Nicklaus228/iSerre/Image/ScreenShot_20170424103108.png

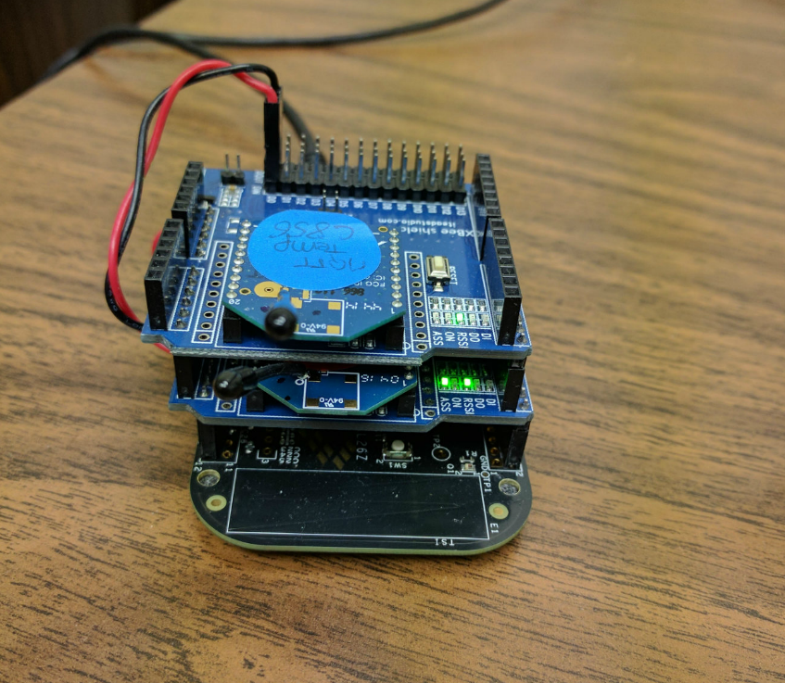
Image/ScreenShot_20170424103108.png
