Nicklaus228/iSerre/Image/passerelle.png

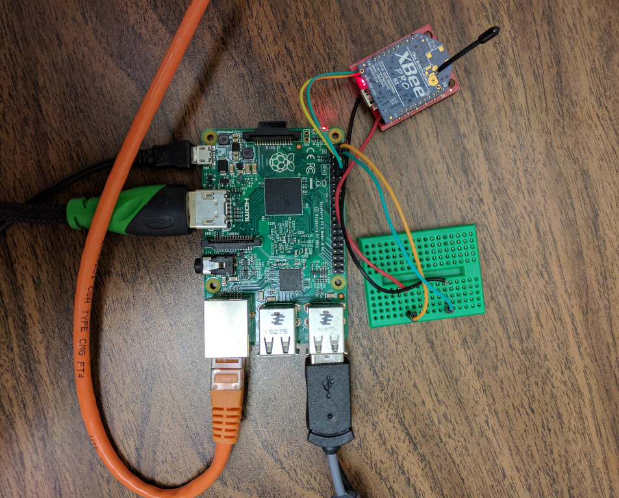
Image/passerelle.png
