Nicklaus228/iSerre/README.md

# iSerre
Ce projet vise à mettre au point une serre électronique automatisée dont les paramètres environnementaux sont configurables par exemple : la température, l’humidité etc. 

Présentation sur prezi : https://prezi.com/t4i6kgrugdgb/
