Nicklaus228/iSerre/Logiciels/Liste des logiciels utilisés.txt

lien google drive vers les logiciels utiliés dans ce projet 

https://drive.google.com/drive/folders/0B7enBIbdItrnTFJWbEdfZEJibTg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
