Nicklaus228/iSerre/Image/Algo.png

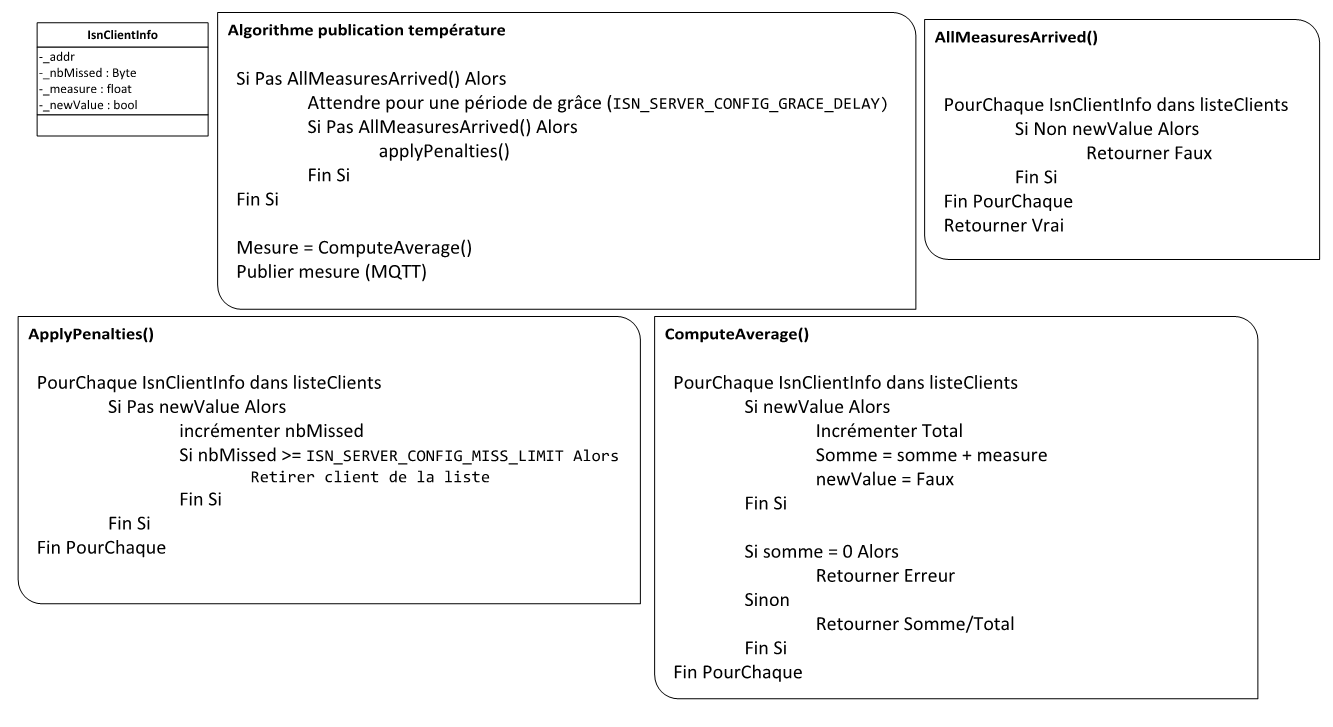
Image/Algo.png
