Nicklaus228/iSerre/Image/architecture.png

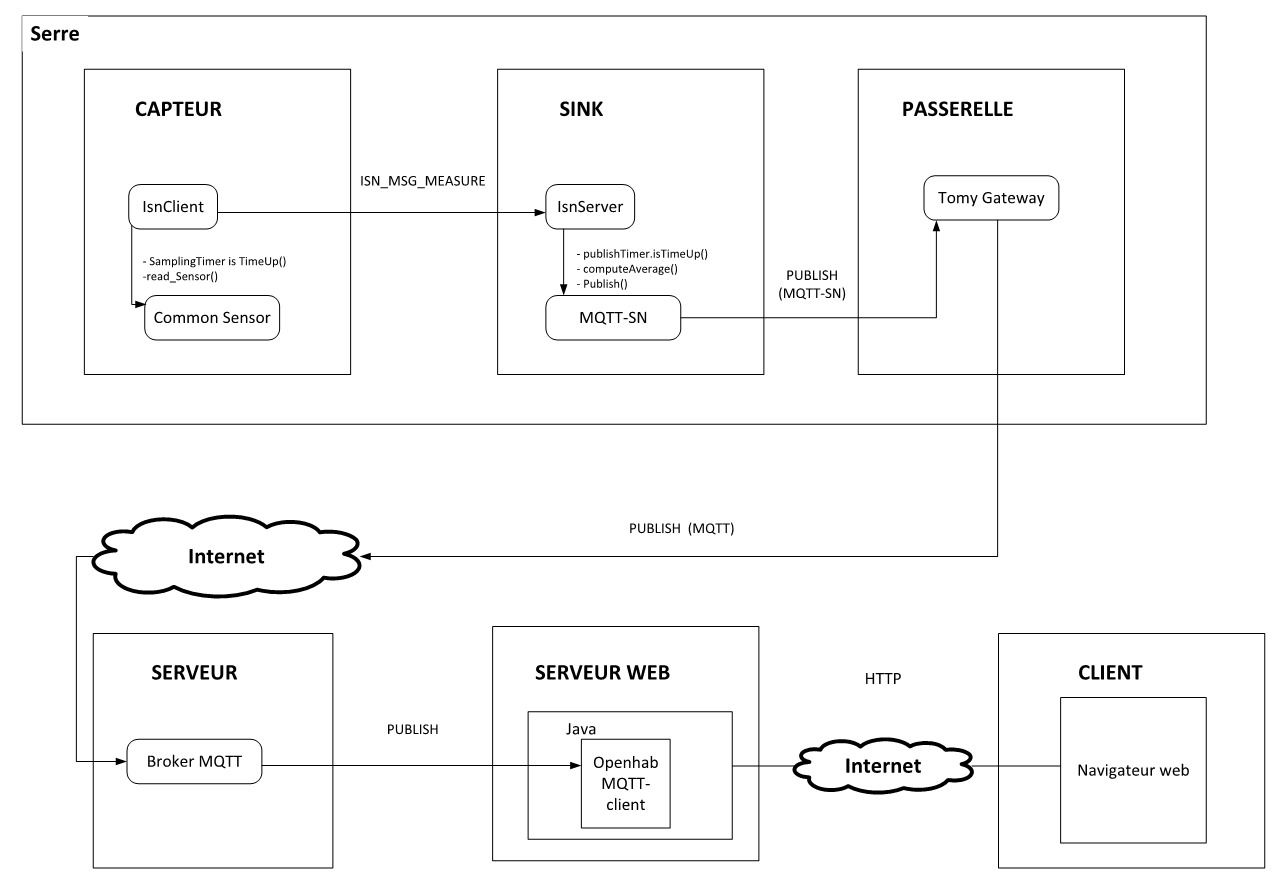
Image/architecture.png
