Nicklaus228/iSerre/Image/Connexion.png

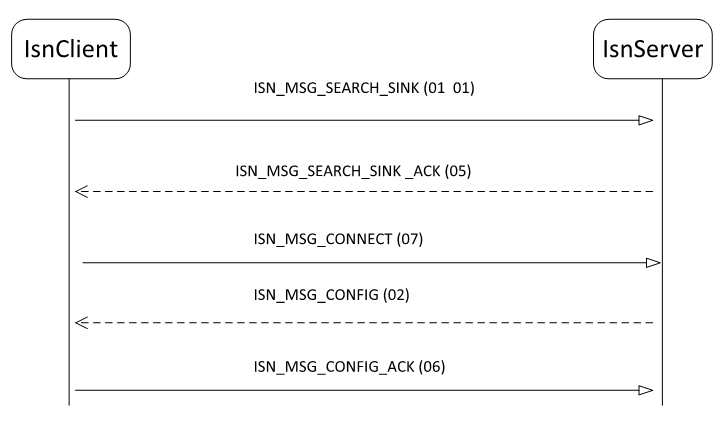
Image/Connexion.png
