Nicklaus228/iSerre/Image/EtatTransition.png

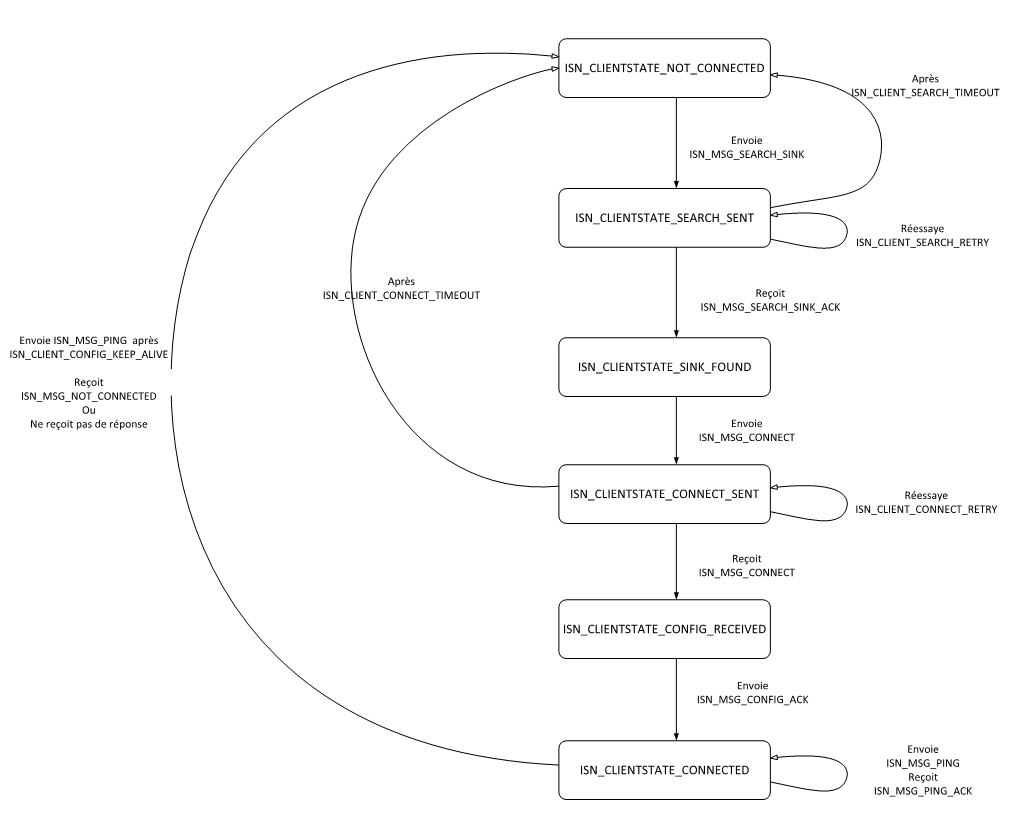
Image/EtatTransition.png
