Nicklaus228/iSerre/Image/keepAlive.png

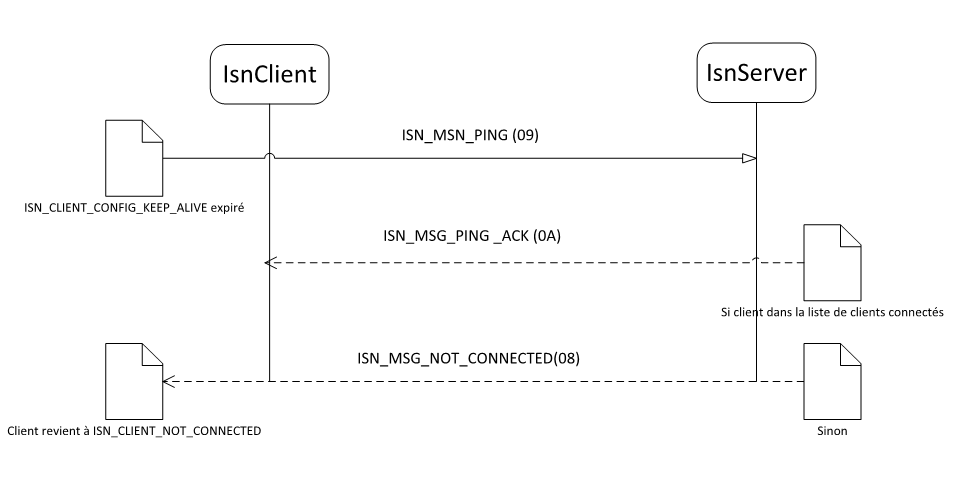
Image/keepAlive.png
