Nicklaus228/iSerre/MQTT-SN-Client/Sources/mqttsn_client_c_interface.h

/*
 * mqttsn_client_c_interface.h
 *
 *  Created on: 2 nov. 2016
 *      Author: Julien
 */

#ifndef SOURCES_MQTTSN_CLIENT_C_INTERFACE_H_
#define SOURCES_MQTTSN_CLIENT_C_INTERFACE_H_

#ifdef __cplusplus
extern "C" {
#endif

int mqttsnClientAppMain();

#ifdef __cplusplus
}
#endif

#endif /* SOURCES_MQTTSN_CLIENT_C_INTERFACE_H_ */
